eSpark-Backup/raafat-bleproduct/README.md

# raafat-BLEproduct

Develop a BLE project that includes PCB design as well as the firmware. Components of the design include:

- Input of external 5 analog sensors through connector with 5V voltage output.
- Gyro, Accelerometer and Temperature sensor, 10 DOF MEMS IMU, all in one IC
- Battery operated, EEMB LIR2450 Rechargeable Battery 3.7V Li-ion Coin (not finialized).
- Battery charging circuit with Type-C USB port.
- RGB LED
- Power Switch
- Header TX RX for debugging
- Power input detect pin
- Battery status detection
- Use smallest size components as a PCB size of 9mm X 9mm needs to be acheived.

- For MCU we can use NRF51822 (suggestions welcome)
