eSpark-Backup/raafat-bleproduct/Design Files/BLE_product-v1.2/Deliverables/_Renderings/2D_Bottom_View.png

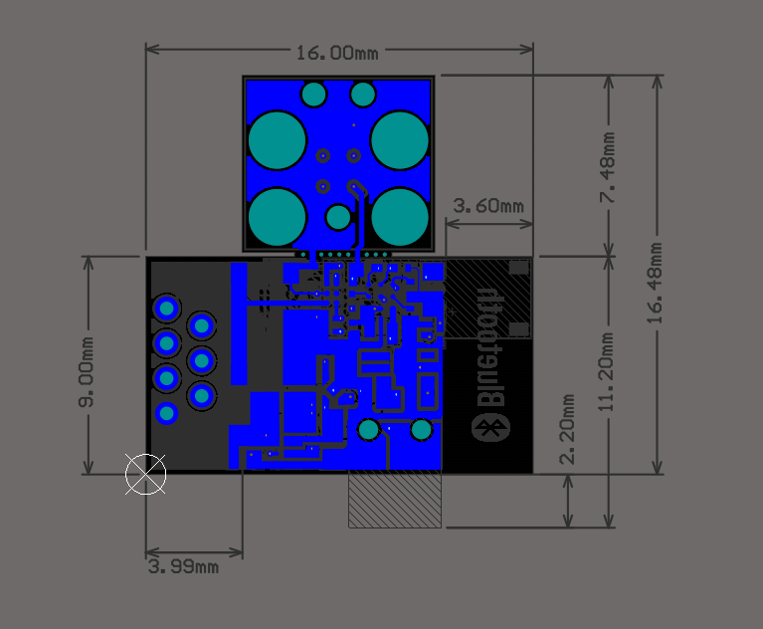
Design Files/BLE_product-v1.2/Deliverables/_Renderings/2D_Bottom_View.png
