eSpark-Backup/raafat-bleproduct/Design Files/BLE_product-v1.2/Deliverables/_Renderings/3D_Isometric_View.png

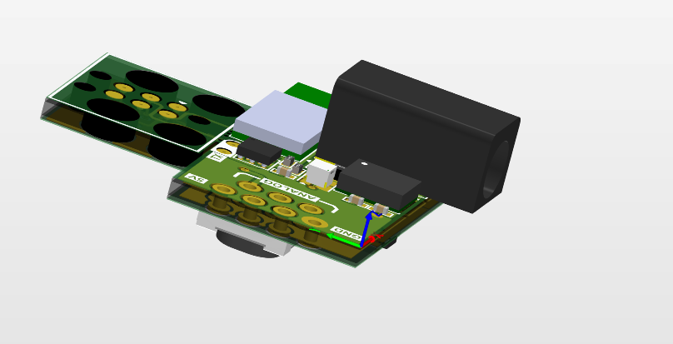
Design Files/BLE_product-v1.2/Deliverables/_Renderings/3D_Isometric_View.png
