eSpark-Backup/raafat-bleproduct/Design Files/BLE_product-v1.2/Deliverables/BOM/BLE_product-v1.2.xlsx

# | Item Type | Designator | Description | Footprint | Manufacturer Part Number | Manufacturer | Value | Quantity | Link | Remarks
1 | Capacitor | C1, C7, C9, C10, C11, C12 | CAP CER 0.1UF 10V X5R 0201 | CAP-0201 | CC0201KRX5R6BB104 | Yageo | 0.1uF | 6
2 | Capacitor | C2 | CAP CER 10UF 10V X5R 0402 | Cap-0402 | CL05A106MP5NUNC | Samsung | 10uF | 1
3 | Capacitor | C3 | CAP CER 22UF 10V X5R 0603 | Cap-0603 | CC0603MRX5R6BB226 | Yageo | 22uF | 1
4 | Capacitor | C4 | CAP CER 1UF 10V X5R 0201 | CAP-0201 | CC0201MRX5R6BB105 | Yageo | 1uF | 1
5 | Capacitor | C5, C14 | CAP CER 2.2UF 10V X5R 0201 | CAP-0201 | CC0201MRX5R6BB225 | Yageo | 2.2uf | 2
6 | Capacitor | C6 | CAP TANT 100UF 20% 6.3V 0603 | F980J107MMAAXE | F980J107MMAAXE | Kyocera AVX | 100uF | 1
7 | Capacitor | C8, C13 | CAP CER 1UF 16V X5R 0201 | CAP-0201 | CC0201MRX5R7BB105 | Yageo | 1uF | 2
8 | SMD Pad | ~~J1, J2, J5, J6~~ | ~~Wire Connecting Pad 0.5mm~~ | ~~1 Sensor Pad 0.5mm~~ | ~~Sensor Pads~~ |  | - | 4 |  | DNP
9 | DC Jack Female | J3 | DC Power Jack Socket Female Panel Mount Connector | DC-096 | DC-096 | CW Switch Elec. Store | DC-096 | 1 | Aliexpress (https://vi.aliexpress.com/item/4001280445381.html)
10 | SMD Pads | ~~J4~~ | ~~Wire Connecting Pad~~ | ~~Sensor-Pads 0.5mm Dia~~ | ~~Sensor Pads~~ |  | - | 1 |  | DNP
11 |  | ~~J7~~ |  | ~~TC2030-IDC-NL_~~ |  |  |  | 1 |  | DNP
12 | Inductor | L1 | FIXED IND 470NH 3.4A 52 MOHM SMD | IND-0806 | 1286AS-H-R47M=P2 | Murata | 470nH | 1
13 | RGB LED | LED1 | Colorless transparence -40℃~+150℃ 正贴 RGB 120° 1010 Light Emitting Diodes (LED) ROHS | XL-1010RGBC-WS2812B | XL-1010RGBC-WS2812B | XINGLIGHT | XL-1010RGBC-WS2812B | 1
14 | Resistor | R1, R3, R5, R8, R12, R13 | RES SMD 10K OHM 5% 1/20W 0201 | Res-0201 | RC0201JR-0710KL | Yageo | 10K | 6
15 | Resistor | R2 | 50mW Thick Film Resistors ±1% ±200ppm/℃ 22kΩ 0201 Chip Resistor - Surface Mount ROHS | Res-0201 | 0201WMF2202TEE | UNI-ROYAL | 22K | 1
16 | Resistor | R4 | 50mW Thick Film Resistors ±1% ±200ppm/℃ 33kΩ 0201 Chip Resistor - Surface Mount ROHS | Res-0201 | 0201WMF3302TEE | UNI-ROYAL | 33k | 1
17 | Resistor | R6 | RES 0.01 OHM 1% 1/4W 0402 | Res-0402 | PE0402FRF470R01L | Yageo | 10mR | 1
18 | Resistor | R7 | RES 5.1K OHM 1% 1/20W 0201 | Res-0201 | RC0201FR-075K1L | Yageo | 5.1K | 1
19 | Resistor | R10, R11 | RES 4.7K OHM 1% 1/20W 0201 | Res-0201 | RC0201FR-074K7L | Yageo | 4.7K | 2
20 | Tactile Switch | SW1 | 3.35mm 2.5mm Oval button 50mA Brick nogging 4.2mm 180gf 12V SMD Tactile Switches ROHS | TSA016A2518A | TSA016A2518A | BZCN | TSA016A2518A | 1
21 | IC | U1 | IC REG BOOST 5V 1A 9WLCSP | WLCSP-9 (1.22x1.22) | FAN48610UC50X | ON Semiconductor / Fairchild | FAN48610UC50X | 1
22 | IC | U2 | IC SUPERVISOR 1 CHANNEL 6WLP | WLP-6(0.83x1.24) | MAX16150AWT+ | Analog Devices | MAX16150AWT+ | 1
23 | IC | U3 | IC REG LINEAR 3V 300MA 4X2SON | X2-SON-4(1x1) | TLV73330PDQNR | Texas Instruments | TLV73330PDQNR | 1
24 | IC | U4 | 500Ma Usb Compatible Single Cell Li-Ion Linear Charger With Float Voltage Of 4.2V / Reel | DFN-6-EP(2x2) | FAN54120MP420X | ON Semiconductor | FAN54120MP420X | 1
25 | IC | U5 | IC FUEL GAUGE LI-ION 1CL 9DSBGA | DSBGA-9 (1.651x1.61) | BQ27426YZFR | Texas Instruments | BQ27426YZFR | 1
26 |  | U6 | RF TXRX MODULE BT TRACE ANT SMD | EYSHSNZWZ | EYSHSNZWZ | Taiyo Yuden | EYSHSNZWZ | 1
27 | IC | U7 | MOSFET N-CH 20V 224MA 3XLLGA | X-LLGA-3 | NTNS3193NZT5G | ON Semiconductor | NTNS3193NZT5G | 1
28 | IC | U8 | IMU ACCEL/GYRO I2C/SPI 14LGA | 14-LGA (2.5x3) | BMI323 | Bosch Sensortec | BMI323 | 1
29 | IC | U9 | SENSOR FLIPCORE/HALL SPI 12WLCSP | 12-WLCSP (1.56x1.56) | BMM150 | Bosch Sensortec | BMM150 | 1
30 | Peripheral |  | 2M 1M 0.5M USB Port to 2.0*0.6mm 2.5*0.7mm 3.5*1.35mm 4.0*1.7mm 5.5*2.1mm 2.5mm x 0.7mm 5V DC Barrel Jack Power Cable Connector (Color: 2.0 X 0.6mm) | - | - | - | - |  | Aliexpress (https://vi.aliexpress.com/item/1005003290388447.html?gatewayAdapt=glo2vnm)
31 | Peripheral |  | TC2030-CTX 6-Pin Cable for ARM Cortex | - | - | - | - |  | Tag-Connect (https://www.tag-connect.com/product/tc2030-ctx-6-pin-cable-for-arm-cortex)
