eSpark-Backup/raafat-bleproduct/Design Files/BLE_product-v1.2/Deliverables/_Supporting Files/BLE_product-v1.2.step

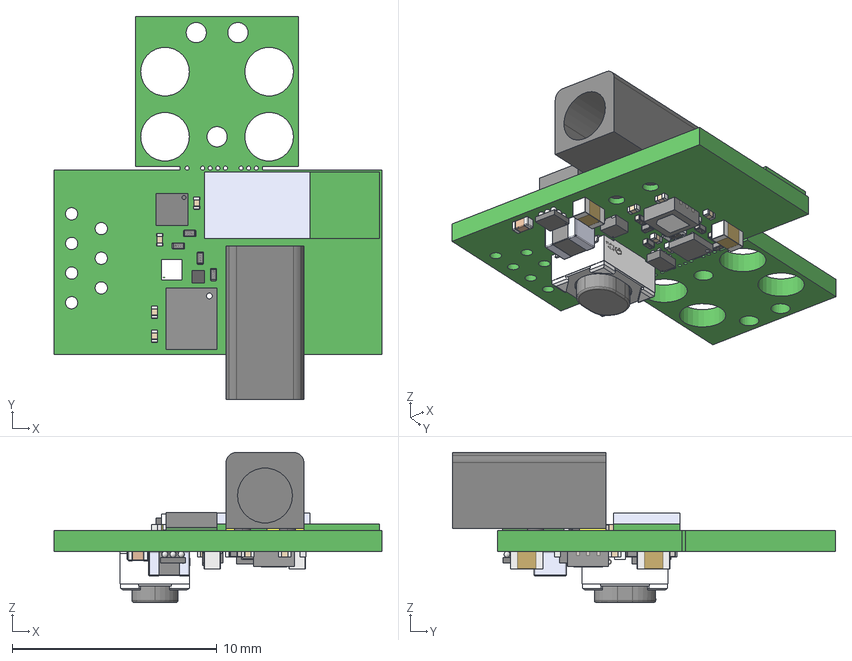
[picture p10: CAD file, 2024-08-15]
Design Files/BLE_product-v1.2/Deliverables/_Supporting Files/BLE_product-v1.2.step
16.0 x 18.7 x 7.32 mm
User Library-SMD Ceramic Capacitors_0201 (0603)_AB x 11
User Library-0201(0603M) Res x 11
part number --------
User Library-CAPC1608X09 x 2
NTNS3193NZT5G
eBom-FreeParts
Pin^BMM150.dwg x 12
LSM6DSLTR--3DModel-STEP-269445
EYSHSNZWZ--3DModel-STEP-56544
BQ27426YZFR
GXCAS-GXHTC3_C2837688
WLCSP9_1P2X1P2_ONS
User Library-RES_1005-0402
COMPOUND.step
1286AS-H-R47M=P2
User Library-Capacitor 0402
