eSpark-Backup/raafat-bleproduct/(list of files, cad)

Other CAD files:
Design Files/BLE_product-v1.2/Deliverables/_Supporting Files/BLE_product-v1.2.DWG
Design Files/BLE_product-v1.2/Deliverables/_Supporting Files/BLE_product-v1.2.DXF
