eSpark-Backup/raafat-bleproduct/Design Files/BLE_product-v1.2/Deliverables/_Schematics/BLE_product-v1.2.pdf

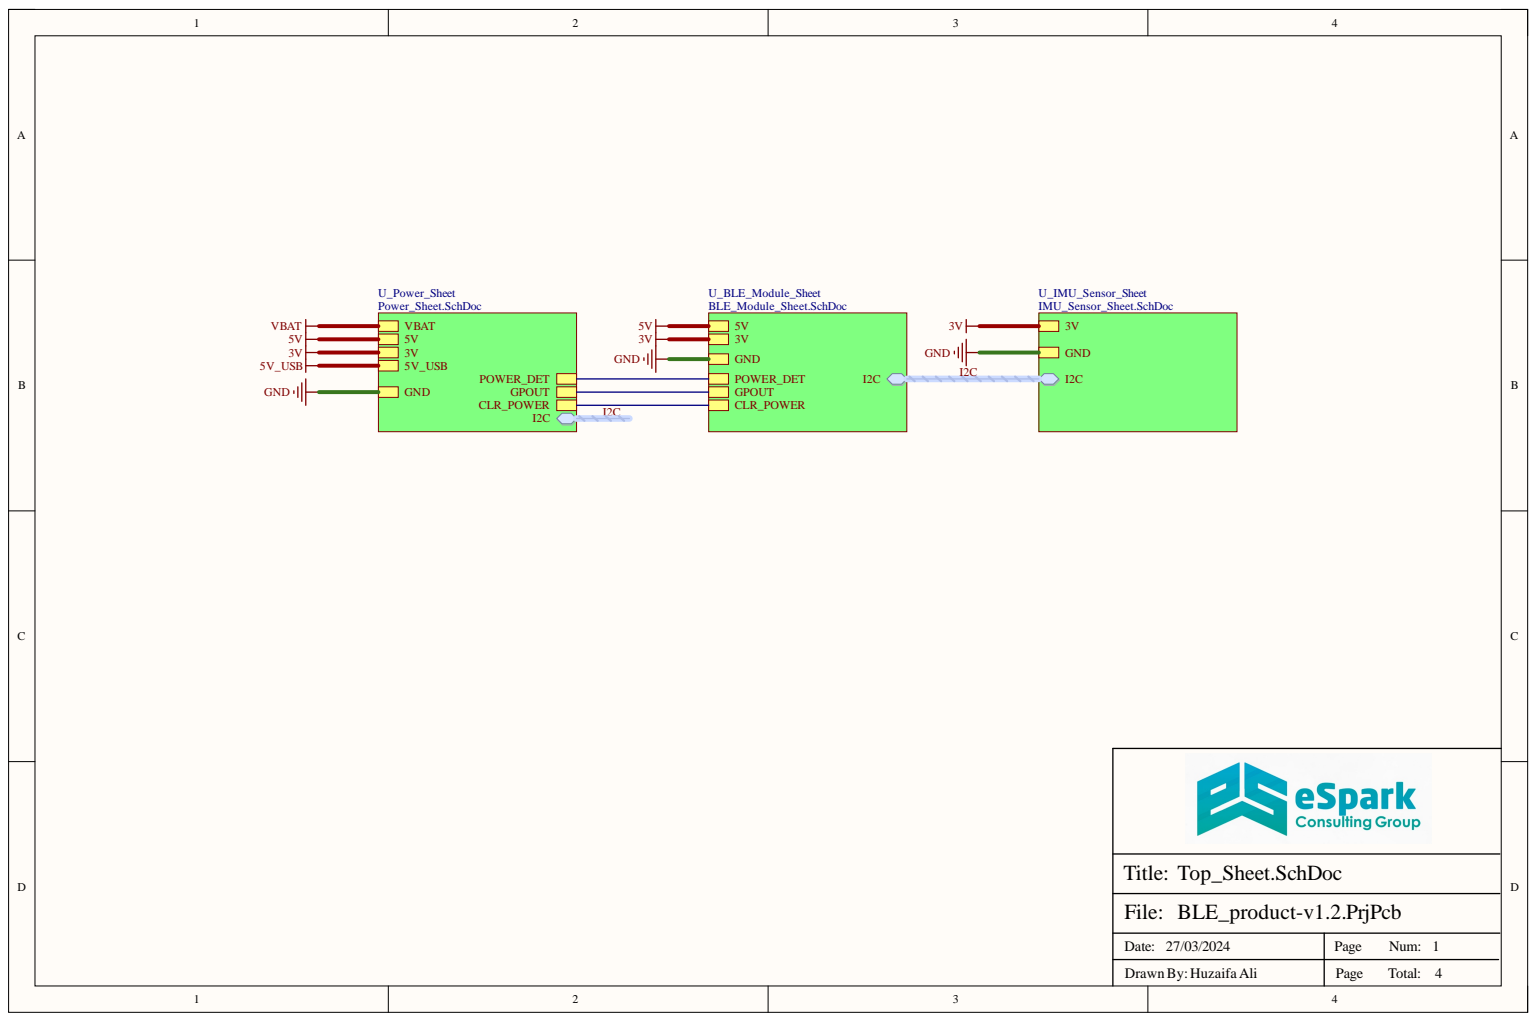
[picture p11: page 1]

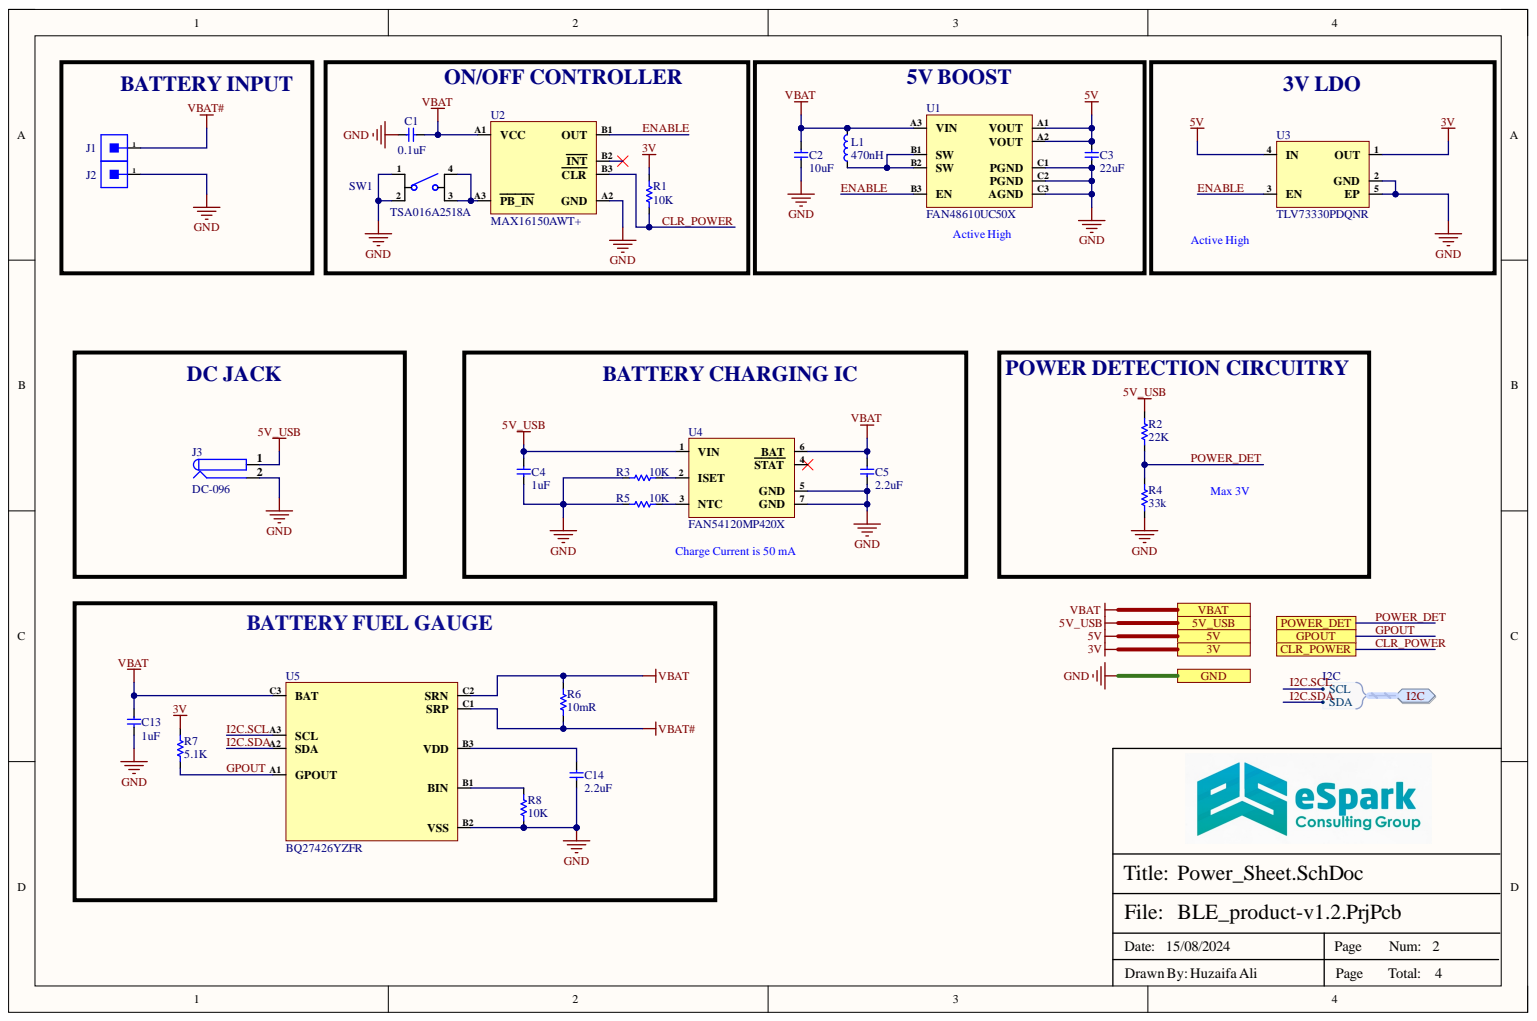
[picture p12: page 2]

Charge Current is 50 mA

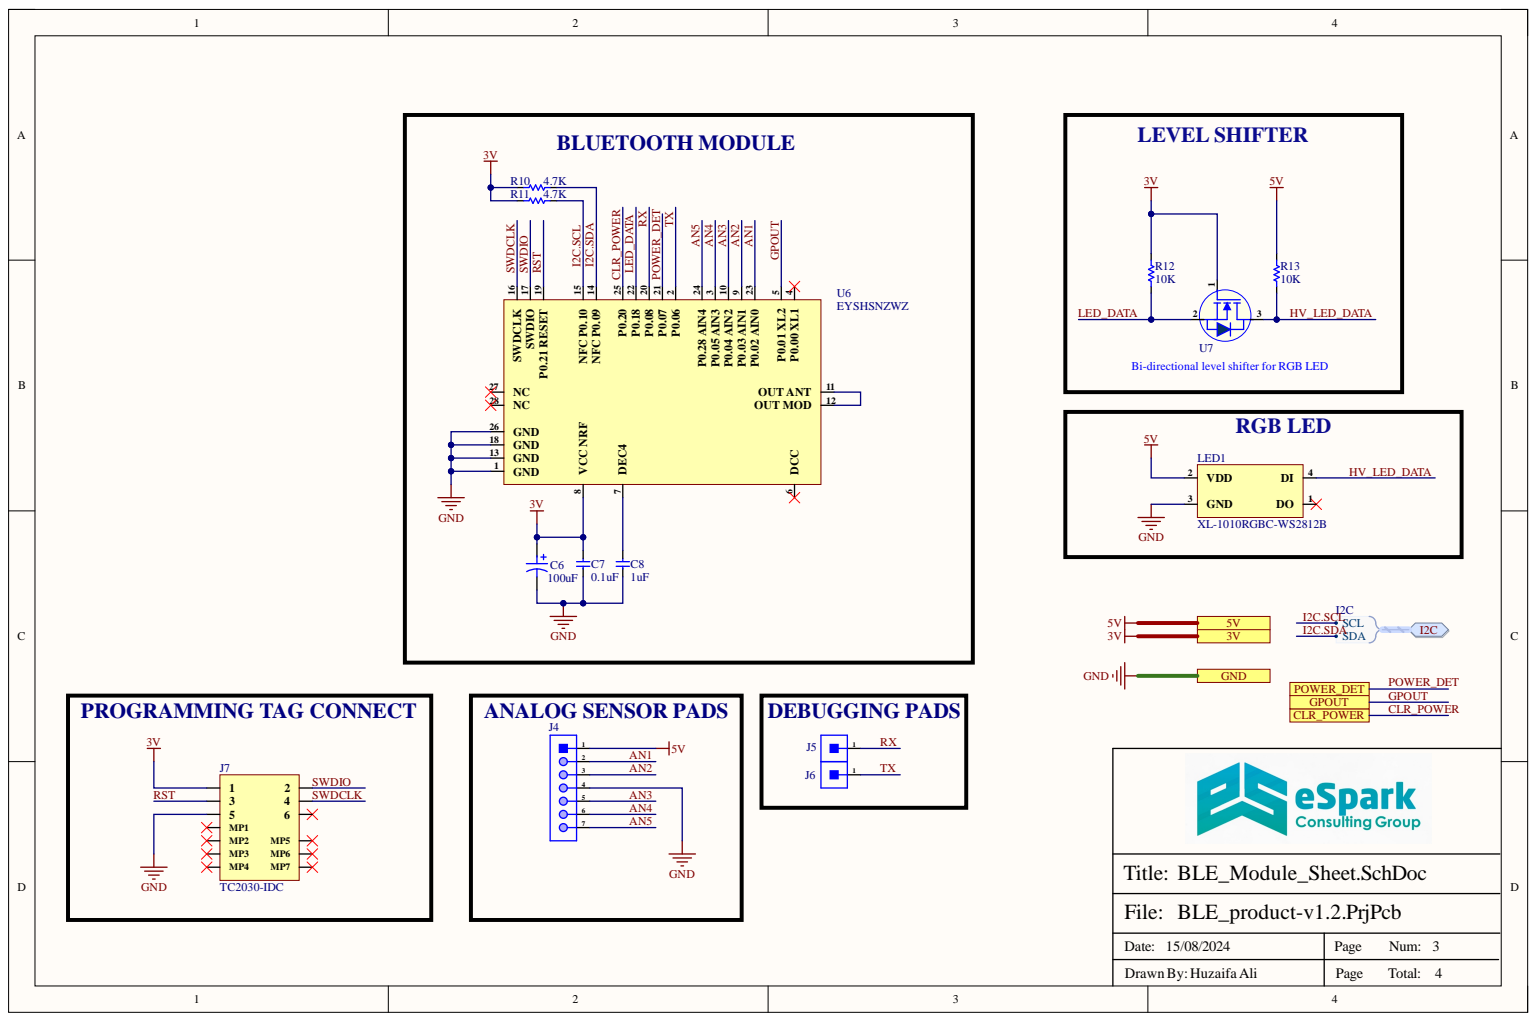
[picture p13: page 3]

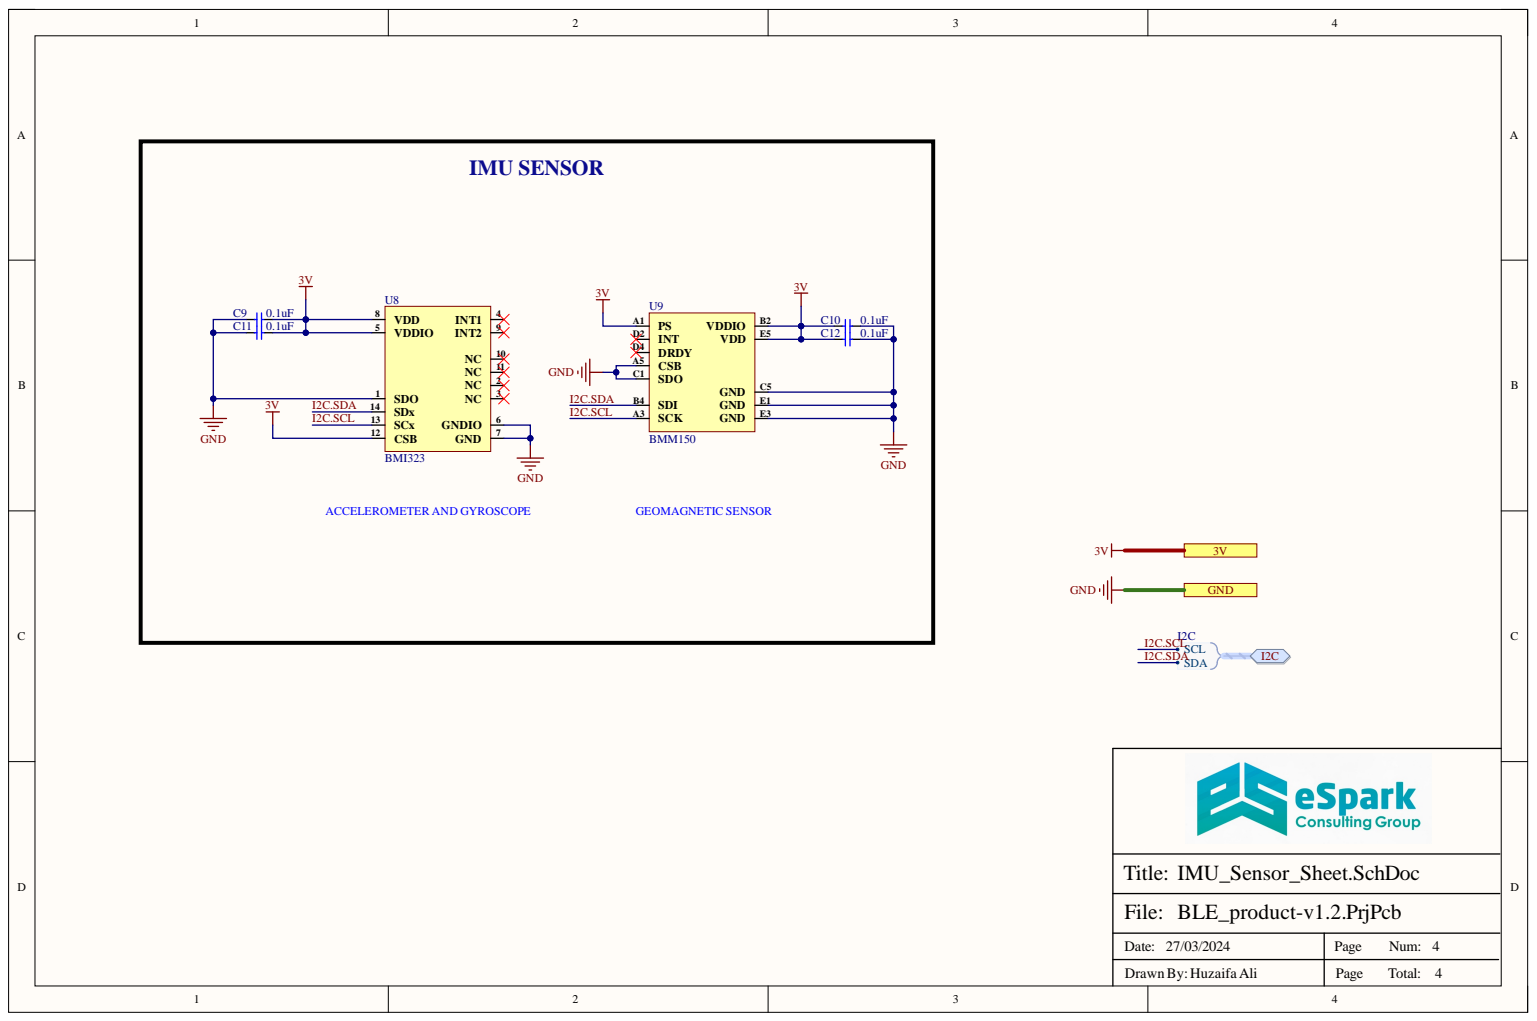
[picture p14: page 4]

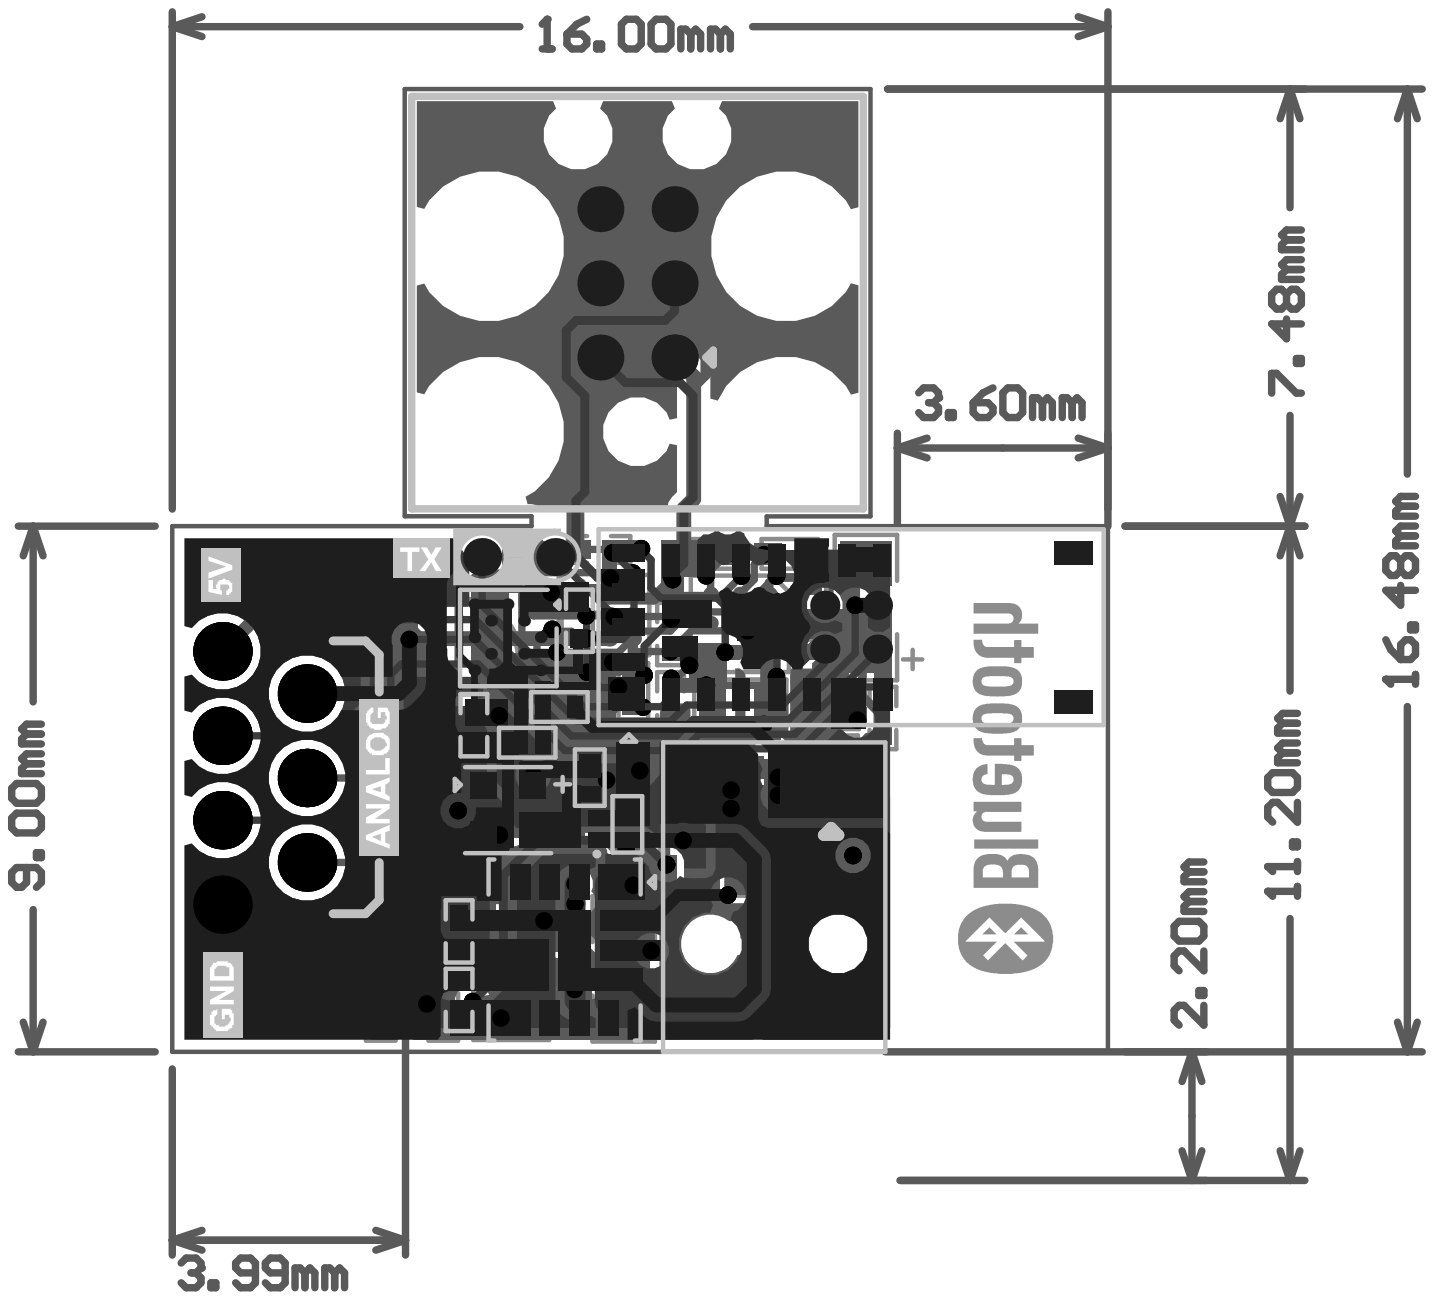
[picture p15: page 5]
