eSpark-Backup/raafat-bleproduct/(list of files, drawings)

Other design files:
Design Files/BLE_product-v1.0/BLE_product-v1.0(Updated Power Jack).PrjPcb
Design Files/BLE_product-v1.0/BLE_product-v1.0.PrjPcb
Design Files/BLE_product-v1.0/BLE_product-v1.1(Updated Power Jack).PrjPcb
Design Files/BLE_product-v1.2/BLE_Module_Sheet.SchDoc
Design Files/BLE_product-v1.2/BLE_product-v1.2.PcbDoc
Design Files/BLE_product-v1.2/BLE_product-v1.2.PrjPcb
Design Files/BLE_product-v1.2/IMU_Sensor_Sheet.SchDoc
Design Files/BLE_product-v1.2/Power_Sheet.SchDoc
Design Files/BLE_product-v1.2/Top_Sheet.SchDoc
