eSpark-Backup/raafat-bleproduct/(commit log)

2023-08-03 #1 Schematic in progress
    [BLE_product-v1.0.PrjPcb, Sheet1.SchDoc]
2023-08-07 #1 IMU sensor remaining
    [BLE_Module_Sheet.SchDoc, BLE_product-v1.0.PrjPcb, IMU_Sensor_Sheet.SchDoc, Power_Sheet.SchDoc]
2023-08-08 #1 Schematic completed except smaller parts replacement
    [BLE_Module_Sheet.SchDoc, BLE_product-v1.0.PrjPcb, IMU_Sensor_Sheet.SchDoc, PCB1.PcbDoc, Power_Sheet.SchDoc]
2023-08-09 #1 Top Sheet
    [BLE_Module_Sheet.SchDoc, BLE_product-v1.0.PrjPcb, IMU_Sensor_Sheet.SchDoc, PCB1.PcbDoc, Power_Sheet.SchDoc, Top_Sheet.SchDoc]
2023-08-10 #1 Schematic completed
    [BLE_Module_Sheet.SchDoc, BLE_product-v1.0.PrjPcb, IMU_Sensor_Sheet.SchDoc, Power_Sheet.SchDoc, Top_Sheet.SchDoc]
2023-08-10 #1 PDF Added
    [BLE_Module_Sheet.SchDoc, BLE_product-v1.0.PrjPcb, IMU_Sensor_Sheet.SchDoc, Power_Sheet.SchDoc, Top_Sheet.SchDoc]
2023-08-11 #1 #2 Changes done
    [BLE_Module_Sheet.SchDoc, BLE_product-v1.0.PrjPcb, IMU_Sensor_Sheet.SchDoc, Power_Sheet.SchDoc, Top_Sheet.SchDoc]
2023-08-11 #2 #1 PDF added
    [IMU_Sensor_Sheet.SchDoc, Power_Sheet.SchDoc, Top_Sheet.SchDoc]
2023-08-11 #1 #2 Inductor and LDO replaced
    [BLE_Module_Sheet.SchDoc, BLE_product-v1.0.PrjPcb, IMU_Sensor_Sheet.SchDoc, Power_Sheet.SchDoc, Top_Sheet.SchDoc]
2023-08-15 #3 #2 #1 Resistors R6,R9 replaced
    [BLE_product-v1.0.PrjPcb, Power_Sheet.SchDoc]
2023-08-15 #3 #2 #1 Switch replaced
    [Power_Sheet.SchDoc]
2023-08-15 Placement Completed
    [BLE_product-v1.0.PcbDoc, BLE_product-v1.0.PrjPcb]
2023-08-16 Placement Updated
    [BLE_product-v1.0.PcbDoc]
2023-08-17 #1 #3 100uf capacitor added
    [BLE_Module_Sheet.SchDoc]
2023-08-17 #3 Placement Updated
    [BLE_product-v1.0(2).PcbDoc, BLE_product-v1.0.PcbDoc, BLE_product-v1.0.PrjPcb]
2023-08-18 #3 #1 C6 replaced
    [BLE_Module_Sheet.SchDoc]
2023-08-18 #3 Routing in Progress
    [BLE_product-v1.0(2).PcbDoc]
2023-08-21 #1 #2 #3 Capacitors updated 100uF added
    [BLE_Module_Sheet.SchDoc, Power_Sheet.SchDoc]
2023-08-22 #3 Routing Completed
    [BLE_Module_Sheet.SchDoc, BLE_product-v1.0(2).PcbDoc, BLE_product-v1.0.PcbDoc, BLE_product-v1.0.PrjPcb]
2023-08-22 #3 Designators updated for Analog points.
    [BLE_product-v1.0.PcbDoc]
2023-08-23 Layer Stackup Updated from 1.6mm to 1mm Thickness
    [BLE_product-v1.0.PcbDoc]
2023-08-23 #3 Power jack moved below BLE to 0.2mm
    [BLE_product-v1.0(Updated Power Jack).PcbDoc, BLE_product-v1.0(Updated Power Jack).PrjPcb, BLE_product-v1.0.PcbDoc]
2023-08-23 #3 Track close to board edge Clearance increased
    [BLE_product-v1.0(Updated Power Jack).PcbDoc, BLE_product-v1.0(Updated Power Jack).PrjPcb]
2023-08-23 #4 Fresh Deliverables Generated (Jack Moved Version)
    [BLE_product-v1.0(Updated Power Jack).DWG, BLE_product-v1.0(Updated Power Jack).DXF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]
2023-09-08 #3 Update Routing in progress
    [BLE_product-v1.0(Updated Power Jack).PcbDoc, BLE_product-v1.0(Updated Power Jack)2.PcbDoc]
2023-09-11 #3 PCB Design Updated and Fresh Deliverables Generated
    [BLE_product-v1.0(Updated Power Jack).DWG, BLE_product-v1.0(Updated Power Jack).DXF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]
2023-11-24 #5 Client BOM add with Peripheral
    [Client BOM.xlsx]
2023-12-06 DC Jack Link added in Client BOM
    [Client BOM.xlsx]
2024-02-06 #6 U4 Updated BOM and Schematic.
    [BLE_product-v1.0(Updated Power Jack).PrjPcb, Client BOM.xlsx, Power_Sheet.SchDoc]
2024-02-06 #6 Version name updated v1.1
    [BLE_product-v1.1(Updated Power Jack).PcbDoc, BLE_product-v1.1(Updated Power Jack).PrjPcb]
2024-03-21 #10 Files renamed
    [BLE_Module_Sheet.SchDoc, BLE_product-v1.0(Updated Power Jack).DWG, BLE_product-v1.0(Updated Power Jack).DXF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]
2024-03-22 #10 Modifications done
    [BLE_Module_Sheet.SchDoc, BLE_product-v1.2.PrjPcb, Power_Sheet.SchDoc, Top_Sheet.SchDoc]
2024-03-26 #10 Parts replaced from temporary to permenant
    [Power_Sheet.SchDoc]
2024-03-27 #10 Net labels corrected
    [Power_Sheet.SchDoc]
2024-03-28 #11 PCB Changes Updated and Fresh Deliverables generated
    [BLE_product-v1.0(Updated Power Jack).DWG, BLE_product-v1.0(Updated Power Jack).DXF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]
2024-03-28 #11 OLD Gerber File Deleted
    [BLE_product-v1.2.PrjPcb]
2024-03-28 DC Jack Cable link update in Client BOM @basit-eSpark FYI
    [BLE_product-v1.2.xlsx]
2024-08-15 #11 Completed and Deliverables Generated
    [BLE_Module_Sheet.SchDoc, BLE_product-v1.2.DWG, BLE_product-v1.2.DXF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]
2024-08-15 #11 BOM updated
    [BLE_product-v1.2.xlsx]
2024-08-16 Tag Connect description fix in BOM #11
    [BLE_product-v1.2.xlsx]
